robomechanics/microtaur/README.md

# microtaur
The design files and code for the microtaur.
