robomechanics/microtaur/Mechanical/Leg.SLDASM

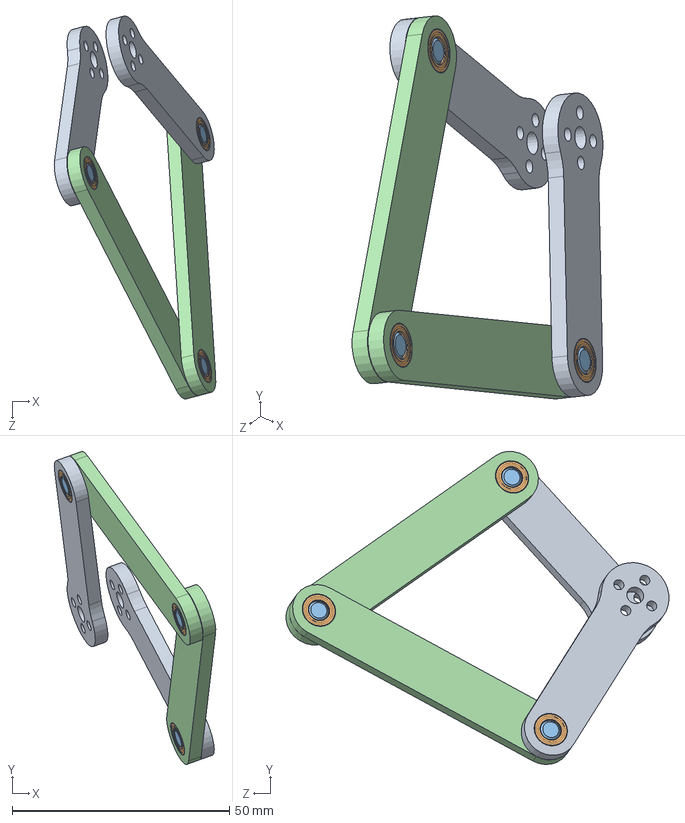
[picture p2: CAD file, 2021-11-02]
Mechanical/Leg.SLDASM
37.2 x 72.1 x 88.2 mm
LegLink1 x 2
3759T53_Precision Stainless Steel Ball Bearing x 6
98381A501_Dowel Pin x 3
LegLink2 x 2
