robomechanics/microtaur/Mechanical/leg_module.SLDASM

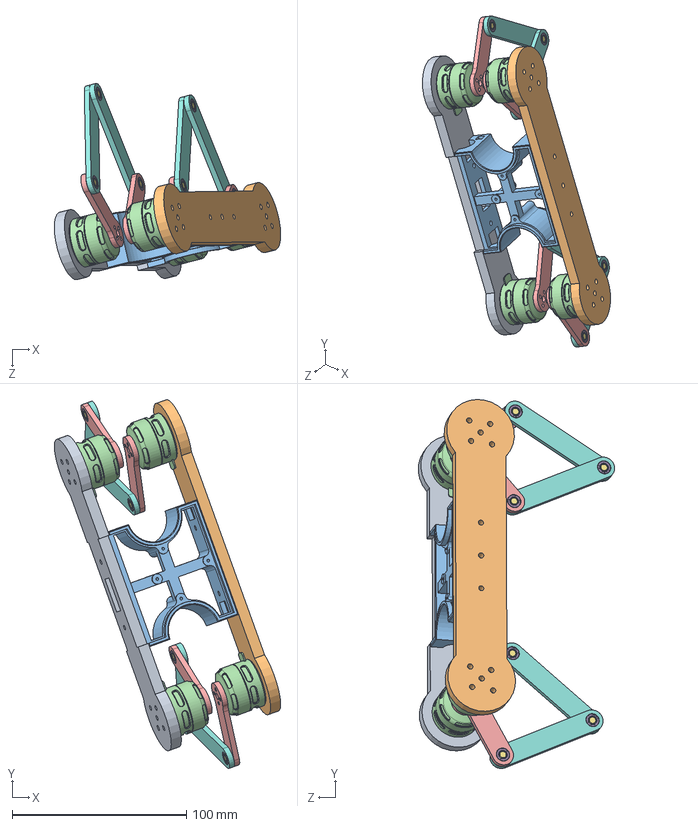
[picture p3: CAD file, 2021-10-24]
Mechanical/leg_module.SLDASM
129.9 x 211.6 x 112.6 mm
Beam_1
beam_spacer
Beam_2
IQ2306 Distributable x 4
LegLink1 x 4
3759T53_Precision Stainless Steel Ball Bearing x 12
98381A501_Dowel Pin x 6
LegLink2 x 4
