robomechanics/microtaur/Mechanical/Fabricated/main_body_v2.SLDPRT

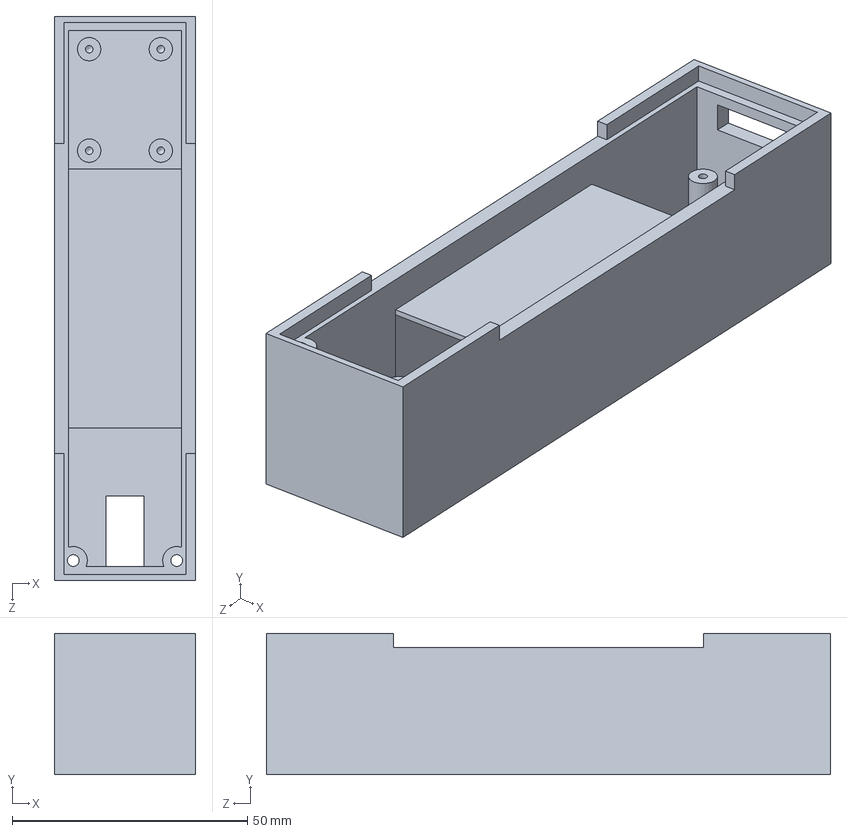
[picture p4: CAD file, 2021-12-16]
Mechanical/Fabricated/main_body_v2.SLDPRT
30.0 x 30.0 x 120.0 mm
