robomechanics/microtaur/Electrical/board_outline.dxf

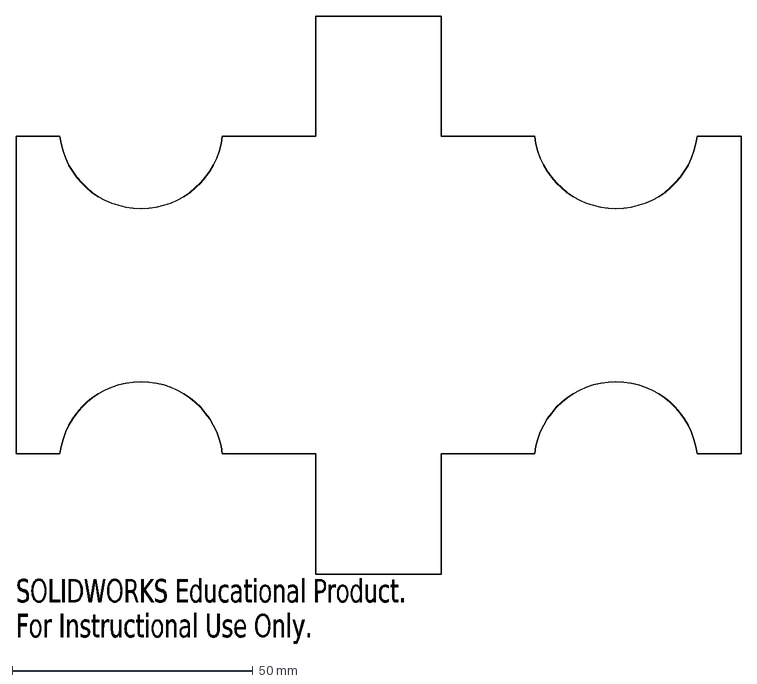
[picture p5: CAD file, 2021-08-12]
Electrical/board_outline.dxf
SOLIDWORKS Educational Product.
For Instructional Use Only.
