robomechanics/microtaur/Mechanical/Fabricated/LegLink3.SLDPRT

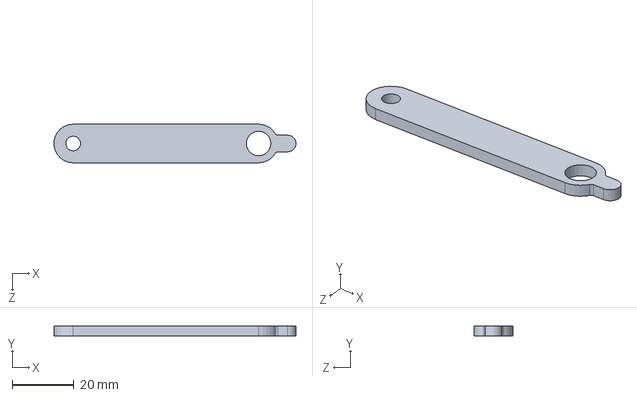
[picture p6: CAD file, 2023-05-04]
Mechanical/Fabricated/LegLink3.SLDPRT
78.3 x 3.17 x 12.5 mm
