robomechanics/microtaur/Mechanical/Fabricated/LegLink2.SLDPRT

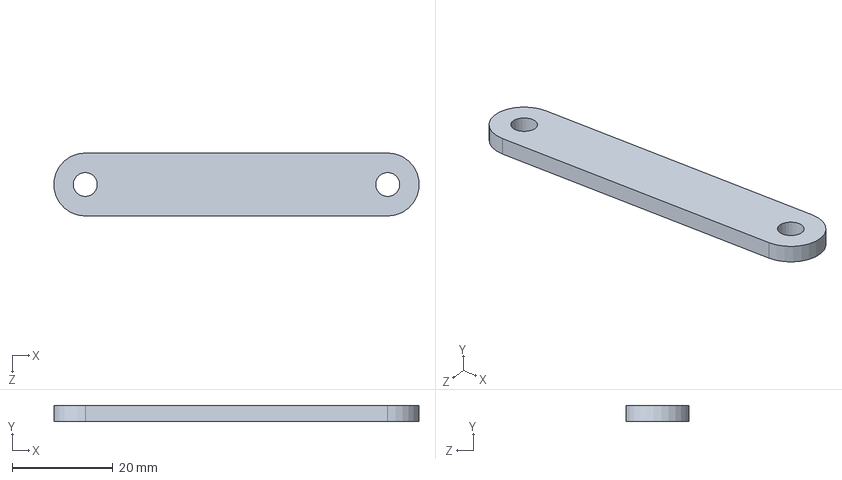
[picture p7: CAD file, 2023-05-04]
Mechanical/Fabricated/LegLink2.SLDPRT
72.4 x 3.17 x 12.5 mm
