robomechanics/microtaur/Mechanical/body shell.SLDPRT

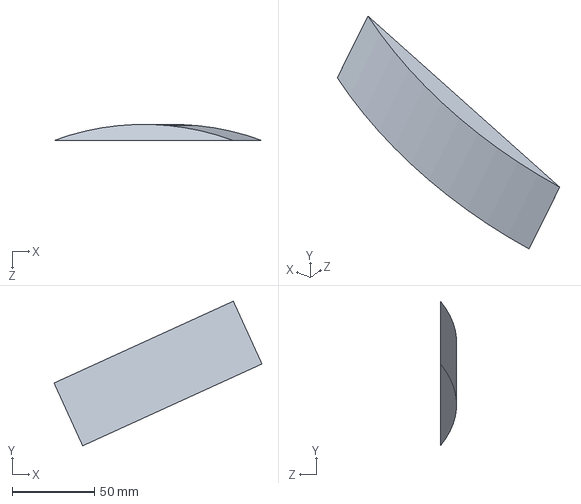
[picture p8: CAD file, 2021-10-20]
Mechanical/body shell.SLDPRT
126.6 x 88.0 x 9.74 mm
