robomechanics/microtaur/Mechanical/Fabricated/LegLink1.SLDPRT

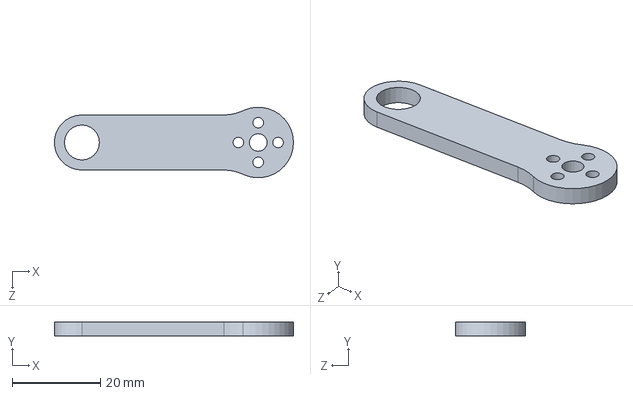
[picture p9: CAD file, 2023-05-04]
Mechanical/Fabricated/LegLink1.SLDPRT
54.2 x 3.17 x 16.0 mm
