robomechanics/microtaur/Mechanical/Fabricated/plate.SLDPRT

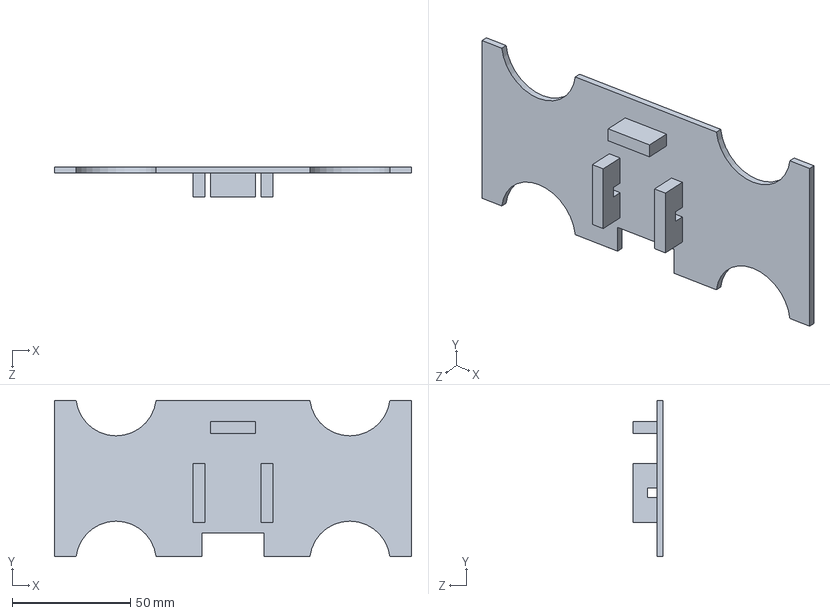
[picture p10: CAD file, 2023-05-04]
Mechanical/Fabricated/plate.SLDPRT
150.7 x 66.0 x 12.5 mm
