robomechanics/microtaur/Mechanical/Fabricated/Beam_1.SLDPRT

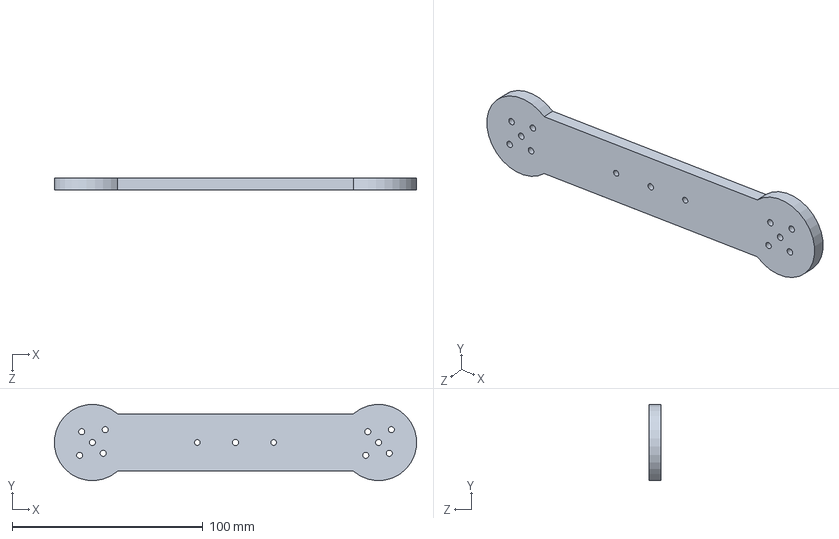
[picture p11: CAD file, 2021-12-16]
Mechanical/Fabricated/Beam_1.SLDPRT
189.8 x 39.9 x 6.35 mm
