robomechanics/microtaur/Mechanical/Fabricated/beam_spacer.SLDPRT

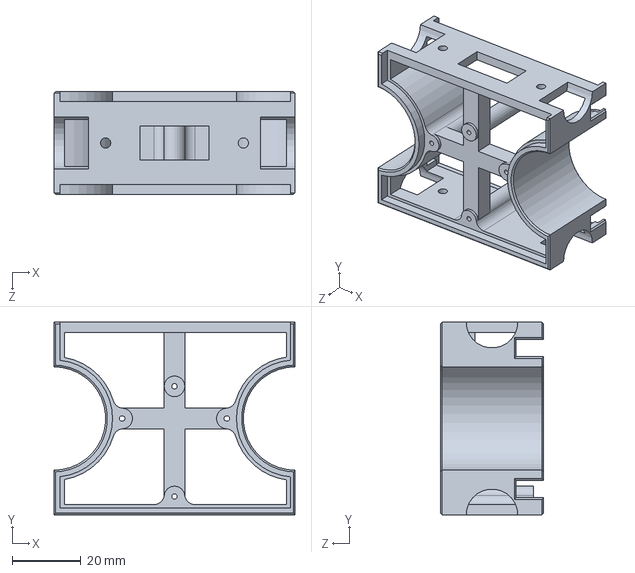
[picture p12: CAD file, 2021-12-16]
Mechanical/Fabricated/beam_spacer.SLDPRT
70.0 x 56.0 x 30.0 mm
