robomechanics/microtaur/Mechanical/Fabricated/Foot.SLDPRT

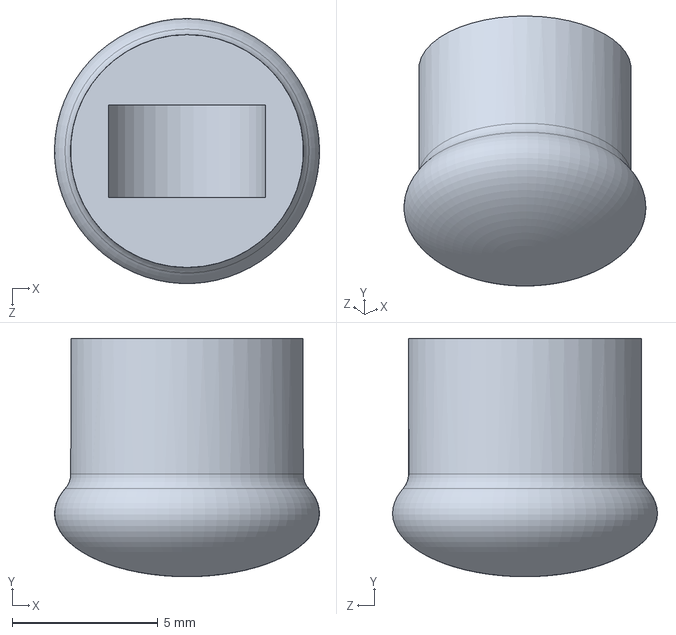
[picture p13: CAD file, 2021-12-16]
Mechanical/Fabricated/Foot.SLDPRT
9.11 x 8.19 x 9.10 mm
