robomechanics/microtaur/Mechanical/Fabricated/Beam_2.SLDPRT

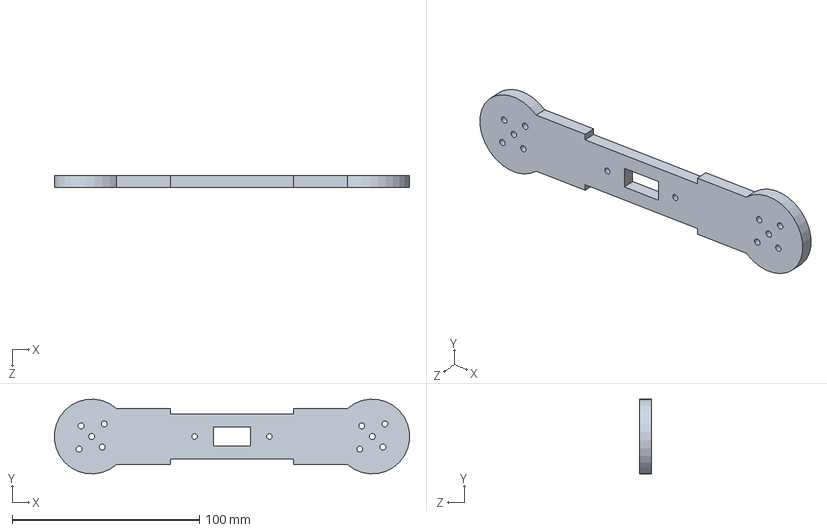
[picture p14: CAD file, 2021-12-16]
Mechanical/Fabricated/Beam_2.SLDPRT
189.8 x 39.9 x 6.35 mm
