robomechanics/microtaur/Mechanical/COTS/3759T53_Precision Stainless Steel Ball Bearing.SLDPRT

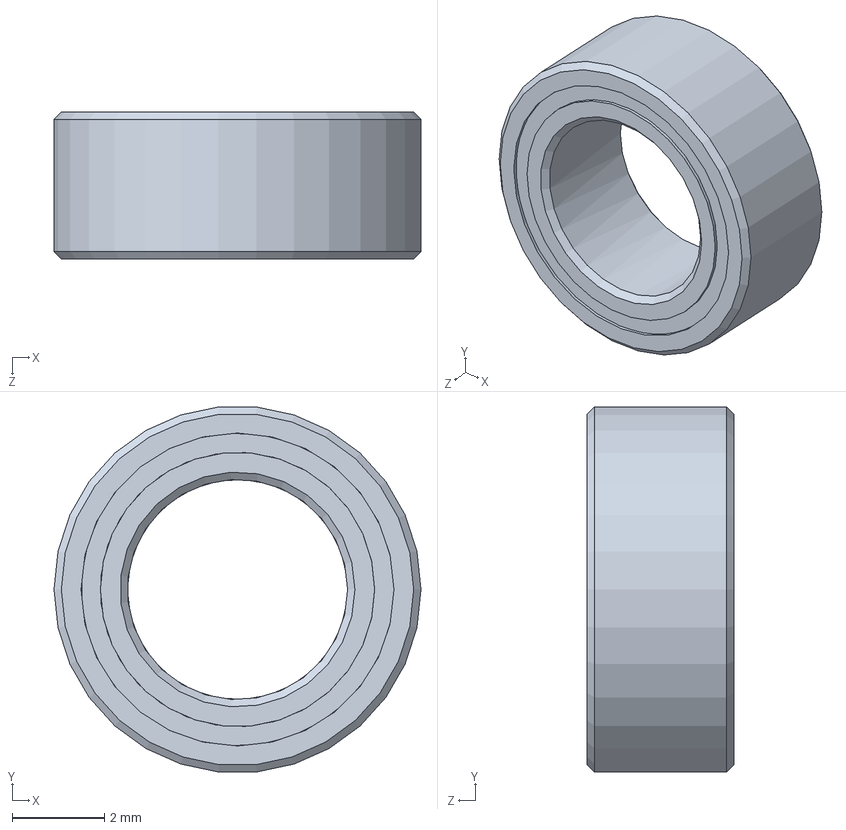
[picture p15: CAD file, 2021-11-02]
Mechanical/COTS/3759T53_Precision Stainless Steel Ball Bearing.SLDPRT
7.94 x 7.89 x 3.17 mm
