robomechanics/microtaur/Mechanical/COTS/98381A501_Dowel Pin.SLDPRT

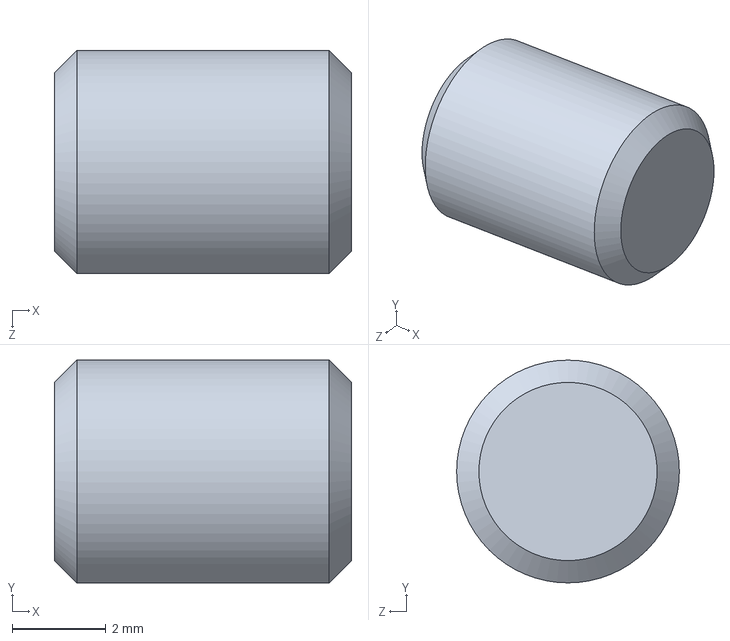
[picture p16: CAD file, 2021-11-02]
Mechanical/COTS/98381A501_Dowel Pin.SLDPRT
6.35 x 4.76 x 4.76 mm
