robomechanics/microtaur/Mechanical/COTS/2517T41_Rubber Slip-on Feet.SLDPRT

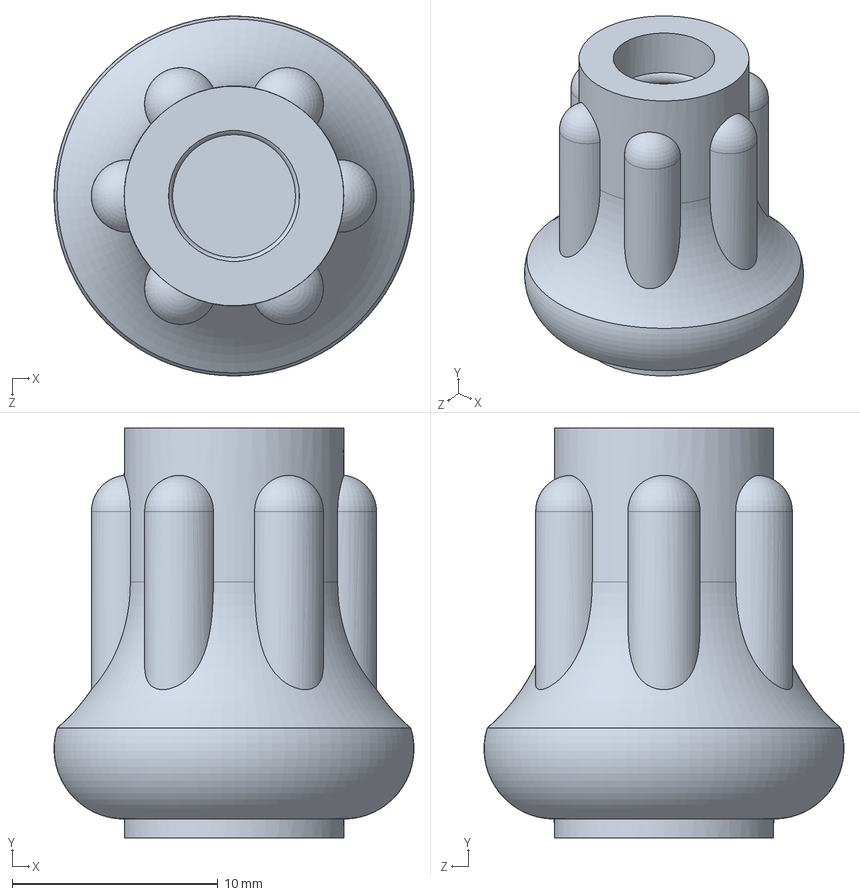
[picture p17: CAD file, 2021-11-02]
Mechanical/COTS/2517T41_Rubber Slip-on Feet.SLDPRT
17.5 x 19.9 x 17.5 mm
