robomechanics/microtaur/Mechanical/COTS/IQ2306 Distributable.SLDPRT

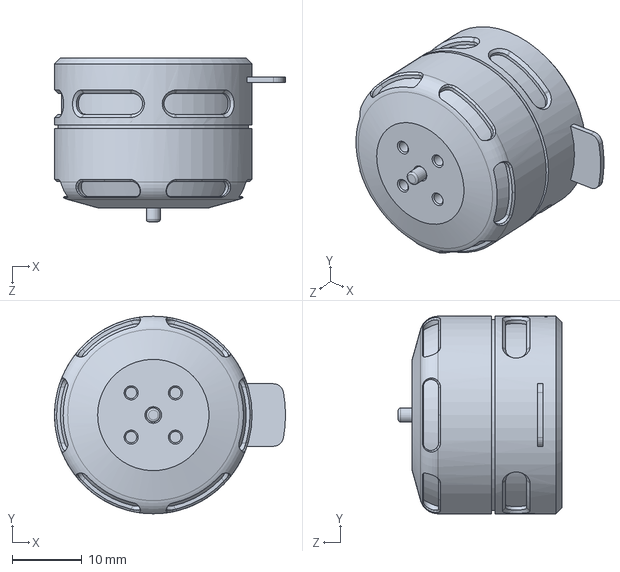
[picture p18: CAD file, 2021-07-02]
Mechanical/COTS/IQ2306 Distributable.SLDPRT
33.2 x 28.4 x 23.5 mm
