robomechanics/microtaur/(list of files, cad)

Other CAD files:
Mechanical/COTS/BNO055 breakout.SLDPRT
Mechanical/COTS/battery.SLDPRT
Mechanical/Fabricated/Beam_1.DXF
Mechanical/Fabricated/Beam_1.STL
Mechanical/Fabricated/Beam_2.DXF
Mechanical/Fabricated/Foot.STL
Mechanical/Fabricated/LegLink1.3MF
Mechanical/Fabricated/LegLink1.DXF
Mechanical/Fabricated/LegLink2.3MF
Mechanical/Fabricated/LegLink2.DXF
Mechanical/Fabricated/LegLink3.3MF
Mechanical/Fabricated/LegLink3.DXF
Mechanical/Fabricated/beam_spacer.STL
Mechanical/Fabricated/main_body_v2.STL
Mechanical/Fabricated/plate.3MF
