robomechanics/microtaur/Electrical/microtaur-teensy41.kicad_pcb

## KiCad design Electrical/microtaur-teensy41.kicad_pcb (2021-10-20)

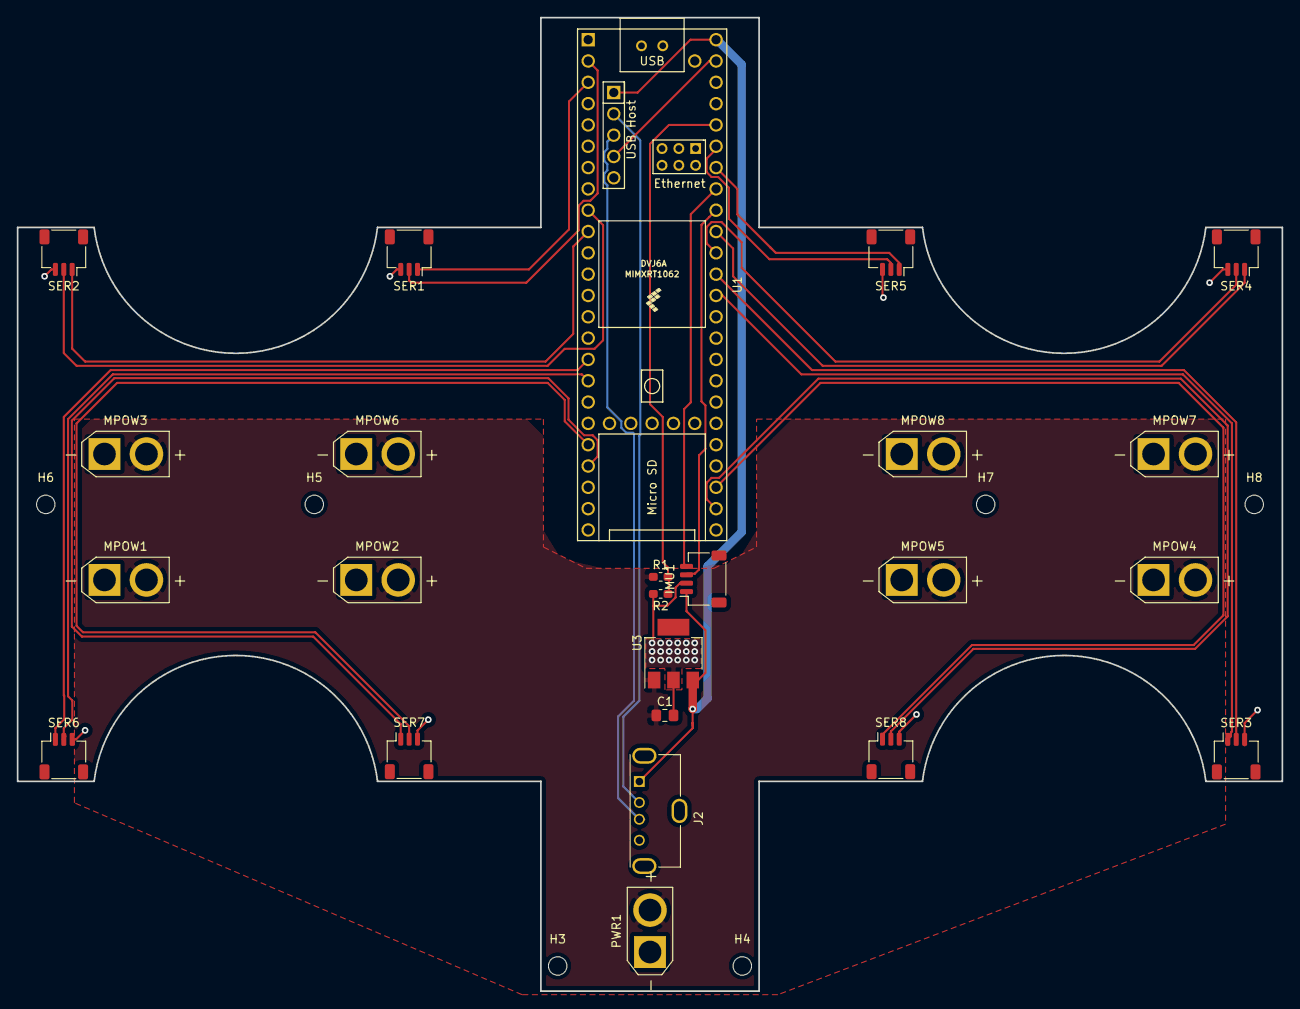
[picture p19: board microtaur-teensy41.kicad_pcb from above]

Board: 2 copper layers, 150.7 x 116.0 mm, 30 parts (0 on the bottom side), 24 nets.

Parts:
C1: 0.22uF; C_0805_2012Metric_Pad1.15x1.40mm_HandSolder
H3, H4, H5, H6, H7, H8: MountingHole; MountingHole_2.2mm_M2
IMU1: Conn_01x04; JST_SH_SM04B-SRSS-TB_1x04-1MP_P1.00mm_Horizontal
J2: USB_A; USB_A_Molex_105057_Vertical
MPOW1, MPOW2, MPOW3, MPOW4, MPOW5, MPOW6, MPOW7, MPOW8: Conn_01x02; AMASS_XT30U-F_1x02_P5.0mm_Vertical
PWR1: Conn_01x02; AMASS_XT30U-F_1x02_P5.0mm_Vertical
R1: 10k; R_0603_1608Metric_Pad1.05x0.95mm_HandSolder
R2: 2.5k; R_0603_1608Metric_Pad1.05x0.95mm_HandSolder
SER1, SER2, SER3, SER4, SER5, SER6, SER7, SER8: Conn_01x03; JST_SH_SM03B-SRSS-TB_1x03-1MP_P1.00mm_Horizontal
U1: Teensy4.1; Teensy41
U3: LM7805_TO220; SOT-223

Connections:
/5V: IMU1.1, J2.1, U1.48, U1.55, U3.3
/BAT_MON: R1.2, R2.1, U1.44
/D+: J2.3, U1.57
/D-: J2.2, U1.56
/RX1: SER1.2, U1.2
/RX2: SER2.2, U1.9
/RX3: SER3.2, U1.37
/RX4: SER4.2, U1.38
/RX5: SER5.2, U1.43
/RX6: SER6.2, U1.17
/RX7: SER7.2, U1.20
/RX8: SER8.2, U1.26
/SCL: IMU1.4, U1.41
/SDA: IMU1.3, U1.40
/TX1: SER1.1, U1.3
/TX2: SER2.1, U1.10
/TX3: SER3.1, U1.36
/TX4: SER4.1, U1.39
/TX5: SER5.1, U1.42
/TX6: SER6.1, U1.16
/TX7: SER7.1, U1.21
/TX8: SER8.1, U1.27
GND: C1.2, IMU1.2, J2.4, J2.5, MPOW1.1, MPOW2.1, MPOW3.1, MPOW4.1, MPOW5.1, MPOW6.1, MPOW7.1, MPOW8.1, PWR1.1, R2.2, SER1.3, SER2.3, SER3.3, SER4.3, SER5.3, SER6.3, SER7.3, SER8.3, U1.1, U1.47, U1.58, U1.59, U3.2
Vdrive: C1.1, MPOW1.2, MPOW2.2, MPOW3.2, MPOW4.2, MPOW5.2, MPOW6.2, MPOW7.2, MPOW8.2, PWR1.2, R1.1, U3.1
