robomechanics/microtaur/Firmware/microtaur/src/hardware/motor.cpp

// #include "motor.h"

// template <unsigned int N>
// void Motor<N>::run()

// template <unsigned int N>
// void Motor<N>::timer_callback(void *arg)

// template <unsigned int N>
// void Motor<N>::init(tprio_t priority)
