robomechanics/microtaur/Firmware/microtaur/include/joystick.h

#pragma once
#include <Arduino.h>
#include "USBHost_t36.h"
#include <bitset>
#include <vector>
#include <functional>
#include "singleton.h"
#include "thread.h"

#define USB_DEVICES 3

extern USBHost usb;
extern USBHub hub;
extern USBHIDParser hid;
extern JoystickController joystick;
extern USBDriver *drivers[];
extern const char *driver_names[USB_DEVICES];
extern USBHIDInput *hiddrivers[];
extern const char *hid_driver_names[USB_DEVICES];
extern bool hid_driver_active[USB_DEVICES];

struct JoyState
{
    std::bitset<12> buttons;
    int axes[4];
};

typedef std::function<void(const JoyState, const JoyState)> CallbackFunction;

class Joystick : public Singleton<Joystick>, public Thread<Joystick, 200>
{
    friend class Singleton<Joystick>;
    JoyState state_;
    JoyState prev_state_;
    bool is_connected_;
    CallbackFunction cb_;
    Joystick();

public:
    void run();
    void connectCallback(CallbackFunction cb)
    {
        cb_ = cb;
    }
    bool isConected() { return is_connected_; }
};
