robomechanics/microtaur/(commit log)

2021-07-02 Added kicad files
    [Teensy_4.0_Assembly.STEP, board_outline.dxf, microtaur-teensy41.kicad_pcb, microtaur-teensy41.sch]
2021-07-02 added gitignore for pcb
2021-07-02 Added mechanical design files
    [BNO055 breakout.SLDPRT, Beam_1.SLDPRT, Beam_2.SLDPRT, IQ2306 Distributable.SLDPRT, battery.SLDPRT, beam_spacer.SLDPRT, leg_module.SLDASM, main_body_v2.SLDPRT]
2021-08-13 added package3d in pcb
    [microtaur-teensy41.kicad_pcb]
2021-08-13 updated solidworks model
    [body shell.SLDPRT, microtaur-teensy41.sch]
2021-09-27 Updated pcb to check compatibility with mcad
    [microtaur-teensy41.kicad_pcb]
2021-09-27 completed pcb design, ready to fab
    [beam_spacer.SLDPRT, leg_module.SLDASM, main_body_v2.SLDPRT, microtaur-teensy41.kicad_pcb, microtaur-teensy41.sch]
2021-10-21 led status indication working
2021-10-24 Added updates to the cad model
    [leg_module.SLDASM]
2021-11-02 added missing mechanical subassemblies
    [2517T41_Rubber Slip-on Feet.SLDPRT, 3759T53_Precision Stainless Steel Ball Bearing.SLDPRT, 98381A501_Dowel Pin.SLDPRT, Leg.SLDASM, LegLink1.SLDPRT, LegLink2.SLDPRT]
2021-11-05 added a multi-threaded iq serial class
2021-11-05 switched the set function to handle only millisecond integers
2021-11-05 improved sleep in machine, switched from a map to an unordered map to store controllers.
2021-11-05 moved imu sleep to the main thread
2021-11-05 updated motor class to use the multi-threaded iq serial libr
2021-11-07 Tested motor thread with 2 motors. Working at 200Hz.
2022-07-20 Update microtaur.h
    Can:
    Bound, (const. speed)
    Walk-trot-fwd (const. speed)
    Walk-trot-bckwd (const. speed)
    Hop
    Enter a spider-like stance (revert)
    Print voltage outputs
    [microtaur.h]
2023-05-04 Modified leg links to minimize number of bearings
    [LegLink1.3MF, LegLink1.DXF, LegLink1.SLDPRT, LegLink2.3MF, LegLink2.DXF, LegLink2.SLDPRT, LegLink3.3MF, LegLink3.DXF]
2023-05-04 Microtaur behavior trials (Voltage Recordings)
    [bound1.xlsx, bound2.xlsx, bound3.xlsx, bound4.xlsx, bound5.xlsx, bound_average.xlsx, hop1.csv, hop2.csv]
